broncoracing/telemetry-transceiver/README.md

# telemetry transceiver
Bronco racing BR24 telemetry transceiver.

Based on an XBee Pro 900HP transceiver, and an STM32F412 microcontroller with two CAN transceivers.
