broncoracing/telemetry-transceiver/th-708726610.jpg

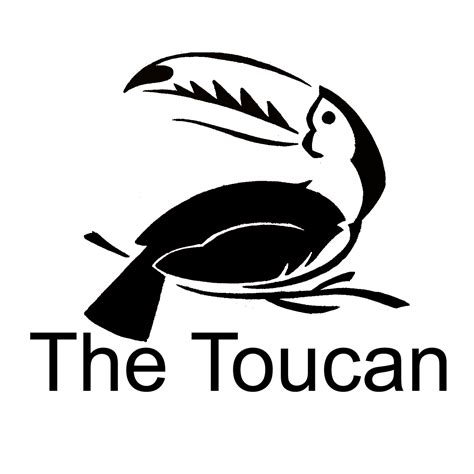
th-708726610.jpg
