broncoracing/telemetry-transceiver/pcb/PCB.kicad_pcb

## KiCad design pcb/PCB.kicad_pcb (2024-02-01)

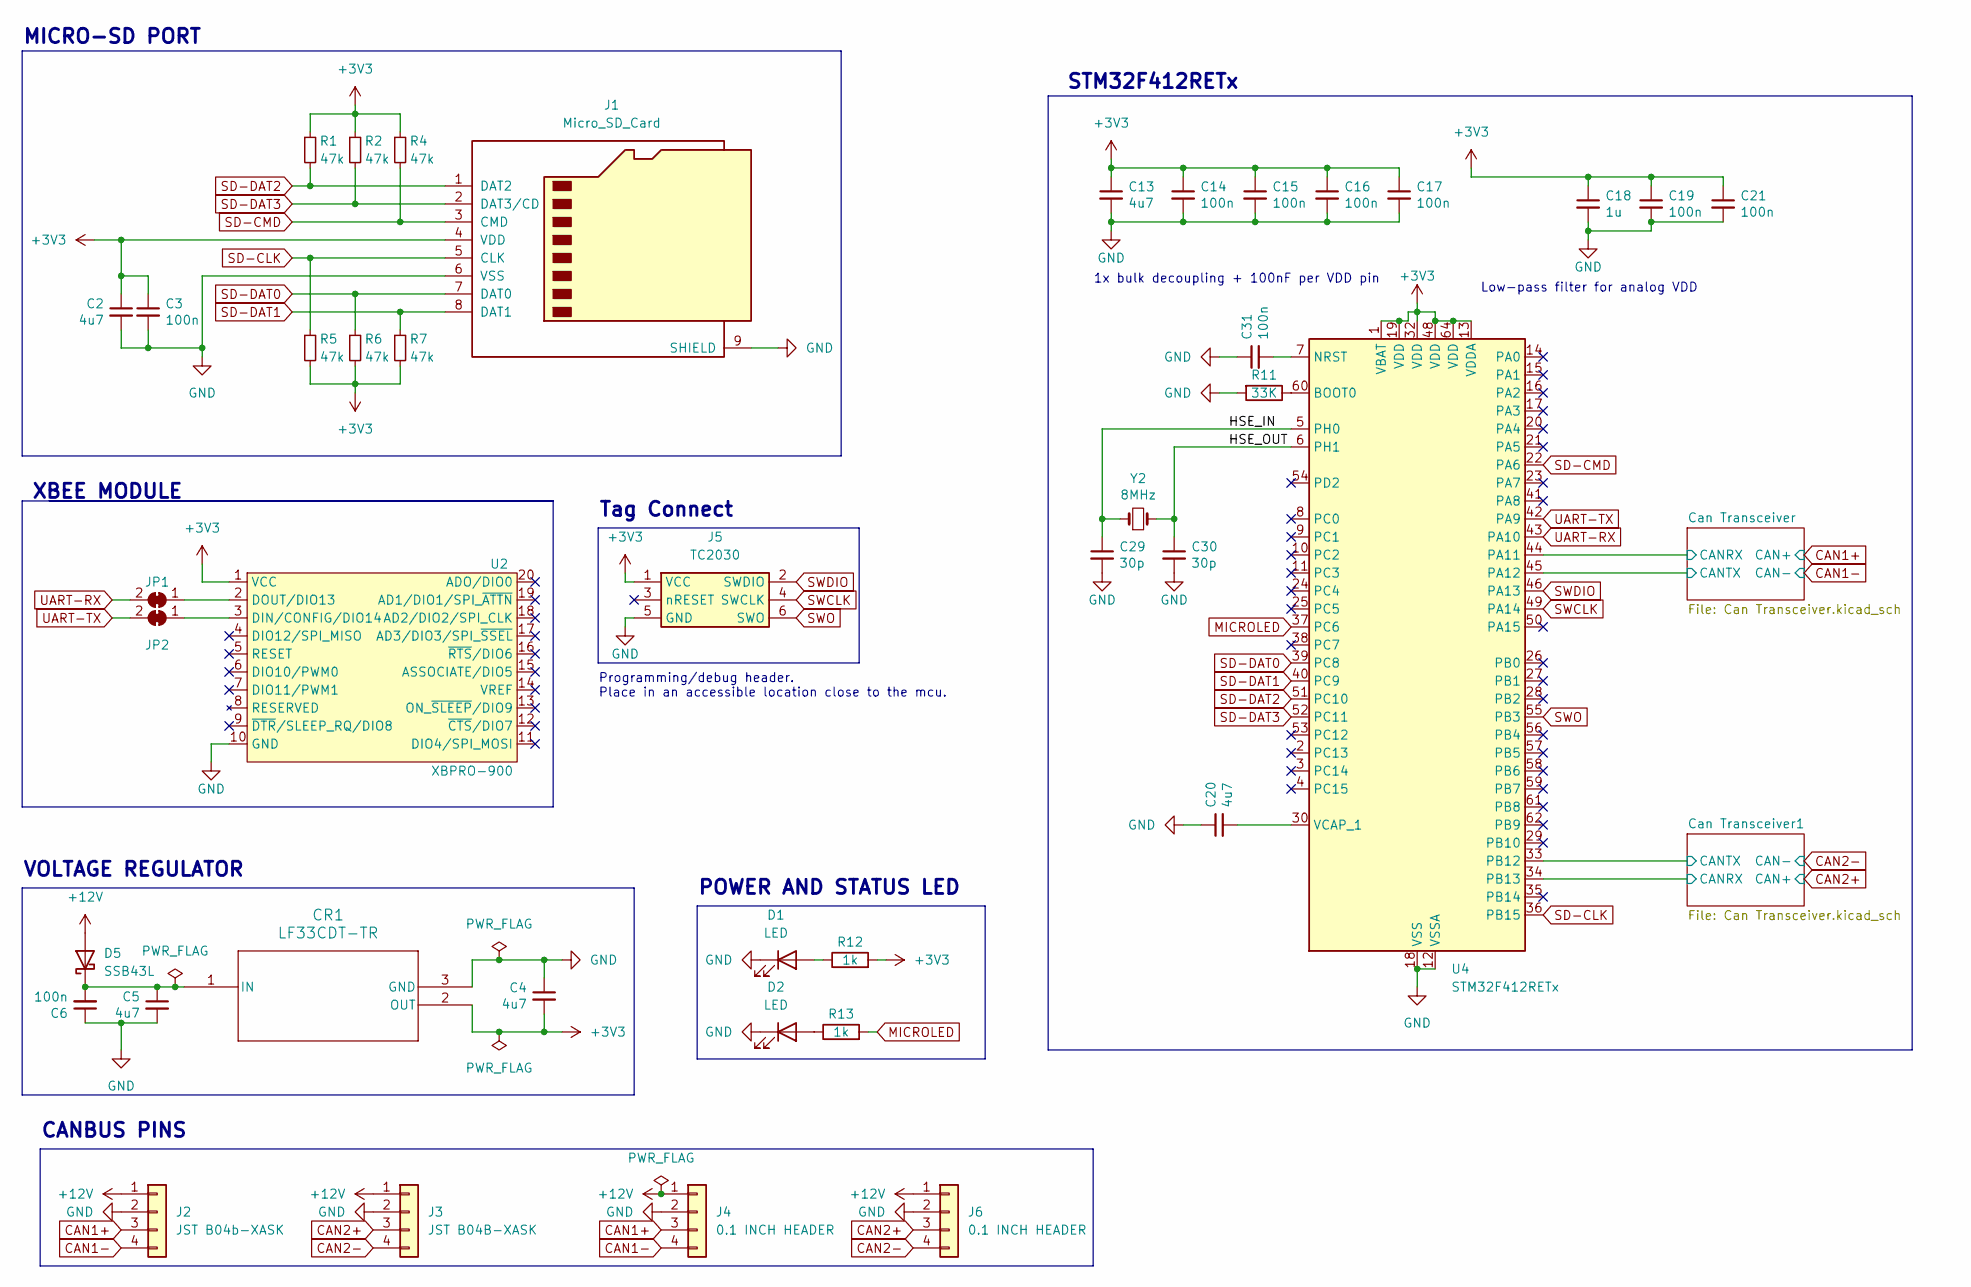
[picture p2: schematic PCB.kicad_sch, STM32F103 Reference Breakout Board]

Parts:
C2, C4, C5, C13, C20: 4u7; C_0603_1608Metric; LCSC C19666
C3, C6, C14, C15, C16, C17, C19, C21, C31: 100n; C_0603_1608Metric; LCSC C307331
C18: 1u; C_0603_1608Metric; LCSC C15849
C29, C30: 30p; C_0603_1608Metric; LCSC C1570
CR1: LF33CDT-TR; DPAK_STM
D1, D2: LED; LED_0603_1608Metric
D5: SSB43L; D_SMB
J1: Micro_SD_Card; microSD_HC_Wuerth_693072010801
J2: JST B04b-XASK; JST_XA_B04B-XASK-1_1x04_P2.50mm_Vertical
J3: JST B04B-XASK; JST_XA_B04B-XASK-1-A_1x04_P2.50mm_Vertical
J4, J6: 0.1 INCH HEADER; PinHeader_1x04_P2.54mm_Vertical
J5: TC2030; Tag-Connect_TC2030-IDC-NL_2x03_P1.27mm_Vertical
JP1, JP2: SolderJumper_2_Bridged; SolderJumper-2_P1.3mm_Bridged_RoundedPad1.0x1.5mm
R1, R2, R4, R5, R6, R7: 47k; R_0603_1608Metric
R11: 33K; R_0603_1608Metric
R12, R13: 1k; R_0603_1608Metric
U2: XBPRO-900; XBEEPRO900HP
U4: STM32F412RETx; LQFP-64_10x10mm_P0.5mm
Y2: 8MHz; Crystal_SMD_5032-2Pin_5.0x3.2mm; LCSC C115962

Connections:
+3V3: C2.1, C3.1, C4.2, C13.1, C14.1, C15.1, C16.1, C17.1, C18.1, C19.1, C21.1, CR1.2 (OUT), J1.4 (VDD), J5.1 (VCC), R1.1, R2.1, R4.1, R5.2, R6.2, R7.2, R12.2, U2.1 (VCC), U4.1 (VBAT), U4.13 (VDDA), U4.19 (VDD), U4.32 (VDD), U4.48 (VDD), U4.64 (VDD); also elsewhere on the board
+12V: D5.2 (A), J2.1, J3.1, J4.1, J6.1
/Can Transceiver1/CANRX: U4.34 (PB13); also elsewhere on the board
/Can Transceiver1/CANTX: U4.33 (PB12); also elsewhere on the board
/Can Transceiver/CANRX: U4.44 (PA11); also elsewhere on the board
/Can Transceiver/CANTX: U4.45 (PA12); also elsewhere on the board
/HSE_IN: C29.1, U4.5 (PH0), Y2.1
/HSE_OUT: C30.1, U4.6 (PH1), Y2.2
CAN1+: J2.3, J4.3; also elsewhere on the board
CAN1-: J2.4, J4.4; also elsewhere on the board
CAN2+: J3.3, J6.3; also elsewhere on the board
CAN2-: J3.4, J6.4; also elsewhere on the board
GND: C2.2, C3.2, C4.1, C5.2, C6.1, C13.2, C14.2, C15.2, C16.2, C17.2, C18.2, C19.2, C20.1, C21.2, C29.2, C30.2, C31.1, CR1.3 (GND), D1.1 (K), D2.1 (K), J1.6 (VSS), J1.9 (SHIELD), J2.2, J3.2, J4.2, J5.5 (GND), J6.2, R11.2, U2.10 (GND), U4.12 (VSSA), U4.18 (VSS), U4.31 (VSS), U4.47 (VSS), U4.63 (VSS); also elsewhere on the board
MICROLED: R13.2, U4.37 (PC6)
unnamed: C5.1, C6.2, CR1.1 (IN), D5.1 (K)
unnamed: D1.2 (A), R12.1
unnamed: D2.2 (A), R13.1
unnamed: JP1.1 (A), U2.2 (DOUT/DIO13)
unnamed: JP2.1 (A), U2.3 (DIN/CONFIG/DIO14)
unnamed: R11.1, U4.60 (BOOT0)
unnamed: C31.2, U4.7 (NRST)
unnamed: C20.2, U4.30 (VCAP_1)
SD-CLK: J1.5 (CLK), R5.1, U4.36 (PB15)
SD-CMD: J1.3 (CMD), R4.2, U4.22 (PA6)
SD-DAT0: J1.7 (DAT0), R6.1, U4.39 (PC8)
SD-DAT1: J1.8 (DAT1), R7.1, U4.40 (PC9)
SD-DAT2: J1.1 (DAT2), R1.2, U4.51 (PC10)
SD-DAT3: J1.2 (DAT3/CD), R2.2, U4.52 (PC11)
SWCLK: J5.4 (SWCLK), U4.49 (PA14)
SWDIO: J5.2 (SWDIO), U4.46 (PA13)
SWO: J5.6 (SWO), U4.55 (PB3)
UART-RX: JP1.2 (B), U4.43 (PA10)
UART-TX: JP2.2 (B), U4.42 (PA9)

Notes on the sheet:
STM32F412RETx
1x bulk decoupling + 100nF per VDD pin
Programming/debug header. Place in an accessible location close to the mcu.
VOLTAGE REGULATOR
XBEE MODULE
POWER AND STATUS LED
CANBUS PINS
MICRO-SD PORT
Tag Connect
Low-pass filter for analog VDD

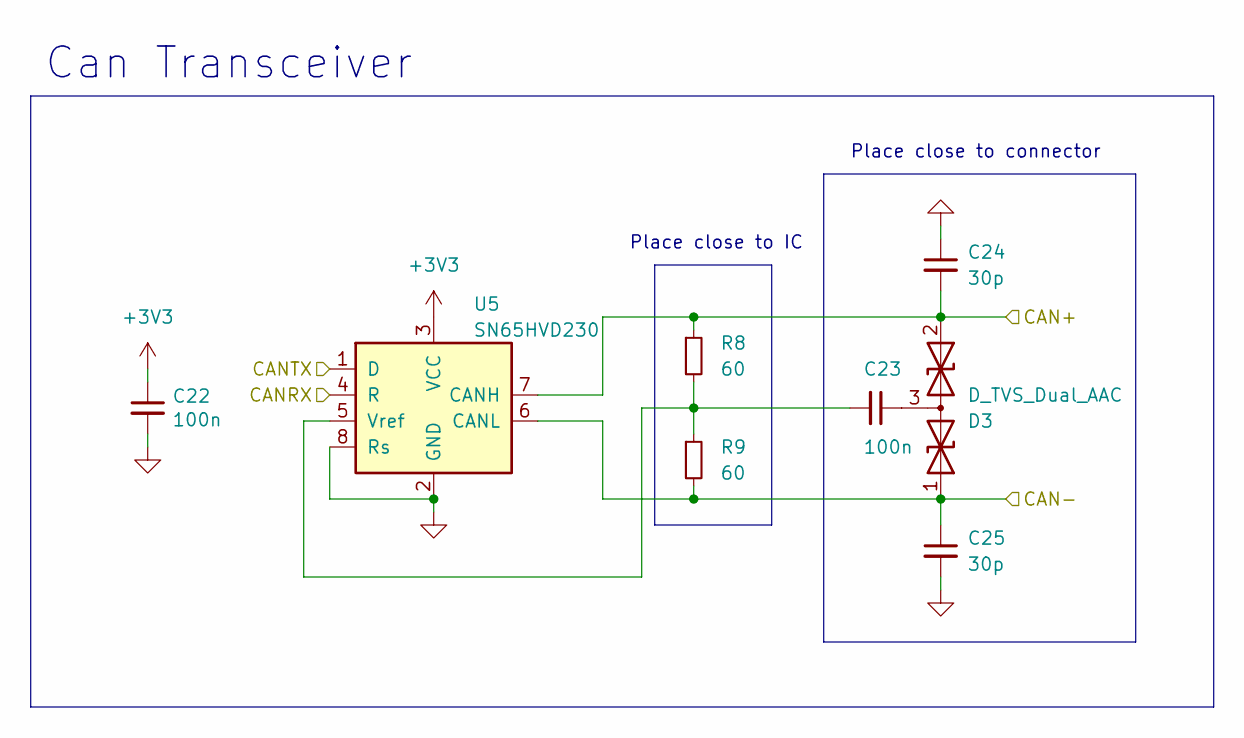
[picture p3: schematic Can Transceiver.kicad_sch]

Parts:
C22, C23: 100n; C_0603_1608Metric; LCSC C307331
C24, C25: 30p; C_0603_1608Metric; LCSC C1570
D3: D_TVS_Dual_AAC; SOT-323_SC-70; LCSC C151237
R8, R9: 60; R_0805_2012Metric; LCSC C441730
U5: SN65HVD230; SOIC-8_3.9x4.9mm_P1.27mm; LCSC C12084

Connections:
+3V3: C22.1, U5.3 (VCC); also elsewhere on the board
/Can Transceiver/CANRX: U5.4 (R); also elsewhere on the board
/Can Transceiver/CANTX: U5.1 (D); also elsewhere on the board
CAN1+: C24.2, D3.2 (A2), R8.1, U5.7 (CANH); also elsewhere on the board
CAN1-: C25.1, D3.1 (A1), R9.2, U5.6 (CANL); also elsewhere on the board
GND: C22.2, C24.1, C25.2, U5.2 (GND), U5.8 (Rs); also elsewhere on the board
unnamed: C23.1, D3.3 (common)
unnamed: C23.2, R8.2, R9.1, U5.5 (Vref)

Parts of its further copies:
C1, C26: 100n; C_0603_1608Metric; LCSC C307331
C27, C28: 30p; C_0603_1608Metric; LCSC C1570
D4: D_TVS_Dual_AAC; SOT-323_SC-70; LCSC C151237
R3, R10: 60; R_0805_2012Metric; LCSC C441730
U1: SN65HVD230; SOIC-8_3.9x4.9mm_P1.27mm; LCSC C12084

Connections of its further copies:
+3V3: C1.1, U1.3 (VCC); also elsewhere on the board
/Can Transceiver1/CANRX: U1.4 (R); also elsewhere on the board
/Can Transceiver1/CANTX: U1.1 (D); also elsewhere on the board
CAN2+: C27.2, D4.2 (A2), R3.1, U1.7 (CANH); also elsewhere on the board
CAN2-: C28.1, D4.1 (A1), R10.2, U1.6 (CANL); also elsewhere on the board
GND: C1.2, C27.1, C28.2, U1.2 (GND), U1.8 (Rs); also elsewhere on the board
unnamed: C26.1, D4.3 (common)
unnamed: C26.2, R3.2, R10.1, U1.5 (Vref)

Notes on the sheet:
Can Transceiver
Place close to connector
Place close to IC

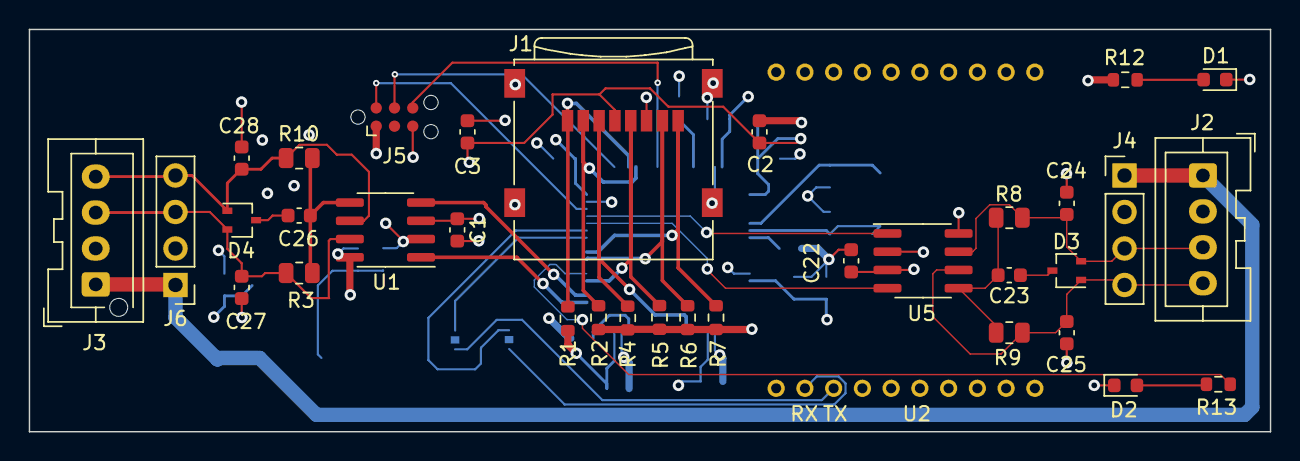
[picture p4: board PCB.kicad_pcb from above]

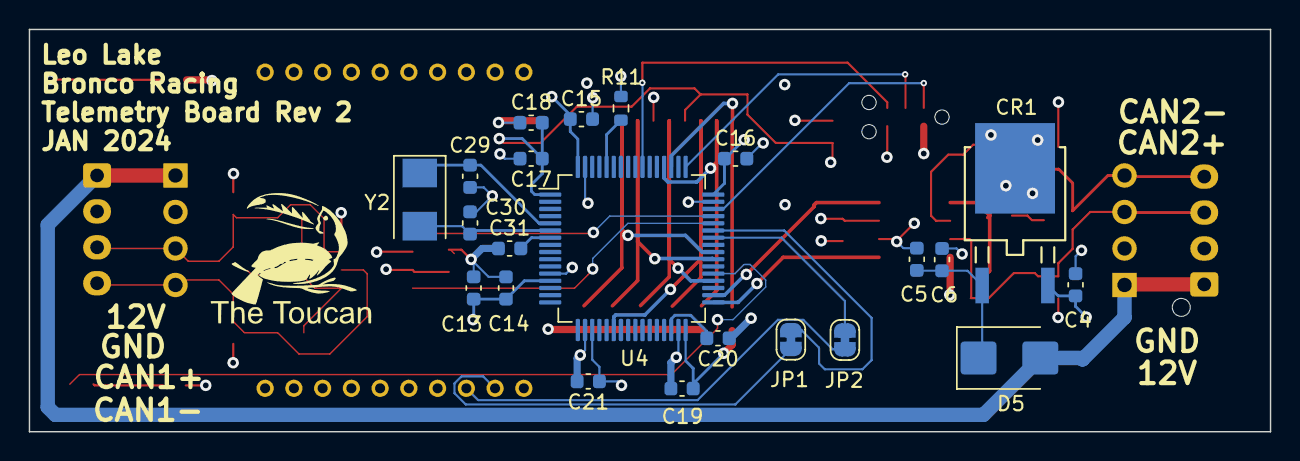
[picture p5: board PCB.kicad_pcb from below]

Board: 4 copper layers, 86.4 x 28.0 mm, 57 parts (22 on the bottom side), 37 nets.
