broncoracing/telemetry-transceiver/telemetry-transceiver.ioc

Mcu.UserName=STM32F412RETx
PA10.Signal=USART1_RX
PA11.Signal=CAN1_RX
PA12.Signal=CAN1_TX
PA13.Signal=SYS_JTMS-SWDIO
PA14.Signal=SYS_JTCK-SWCLK
PA6.Signal=SDIO_CMD
PA9.Signal=USART1_TX
PB12.Signal=CAN2_RX
PB13.Signal=CAN2_TX
PB15.Signal=SDIO_CK
PB3.Signal=SYS_JTDO-SWO
PC10.Signal=SDIO_D2
PC11.Signal=SDIO_D3
PC8.Signal=SDIO_D0
PC9.Signal=SDIO_D1
