broncoracing/telemetry-transceiver/(commit log)

2023-10-13 Removed Kicad Library folder
2023-10-27 created schematic and layout of the telemetry board
    [Can Transceiver.kicad_sch, PCB.kicad_pcb, PCB.kicad_sch]
2024-02-01 Finished Telemetry PCB
    [PCB.kicad_pcb]
